AcheronProject/Jiu/resources/jiu_plate.dxf

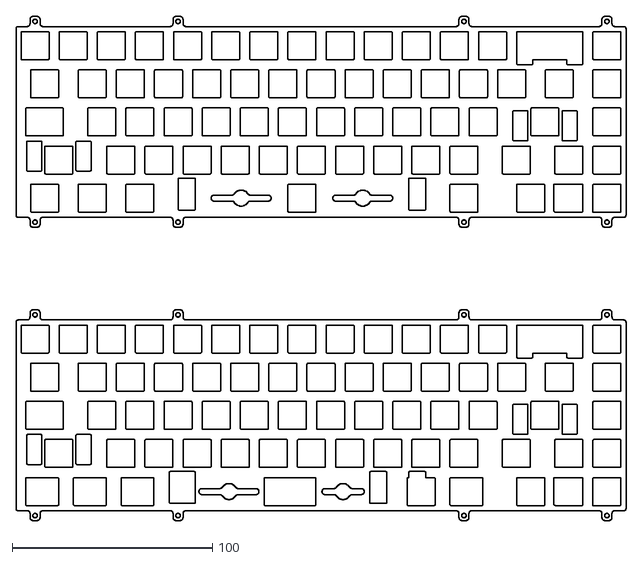
[picture p1: CAD file, 2021-01-12]
resources/jiu_plate.dxf
304.8 x 251.9
