AcheronProject/Jiu/resources/jiu.dxf

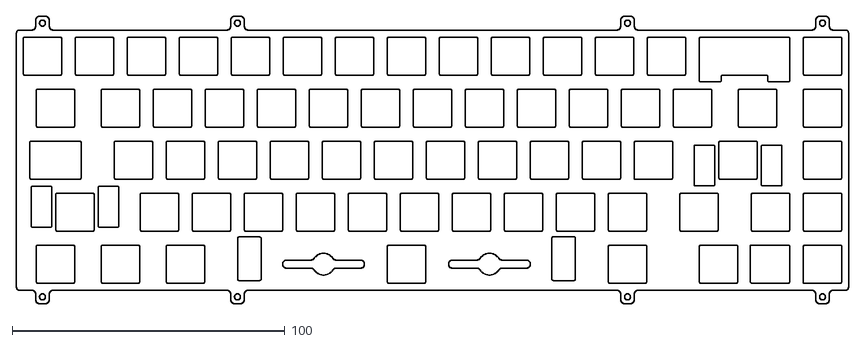
[picture p2: CAD file, 2021-01-12]
resources/jiu.dxf
304.8 x 105.3
