AcheronProject/Jiu/pcb_kicad_files/jiu.kicad_sch

## KiCad design pcb_kicad_files/jiu.kicad_sch (2021-12-22, an earlier design)

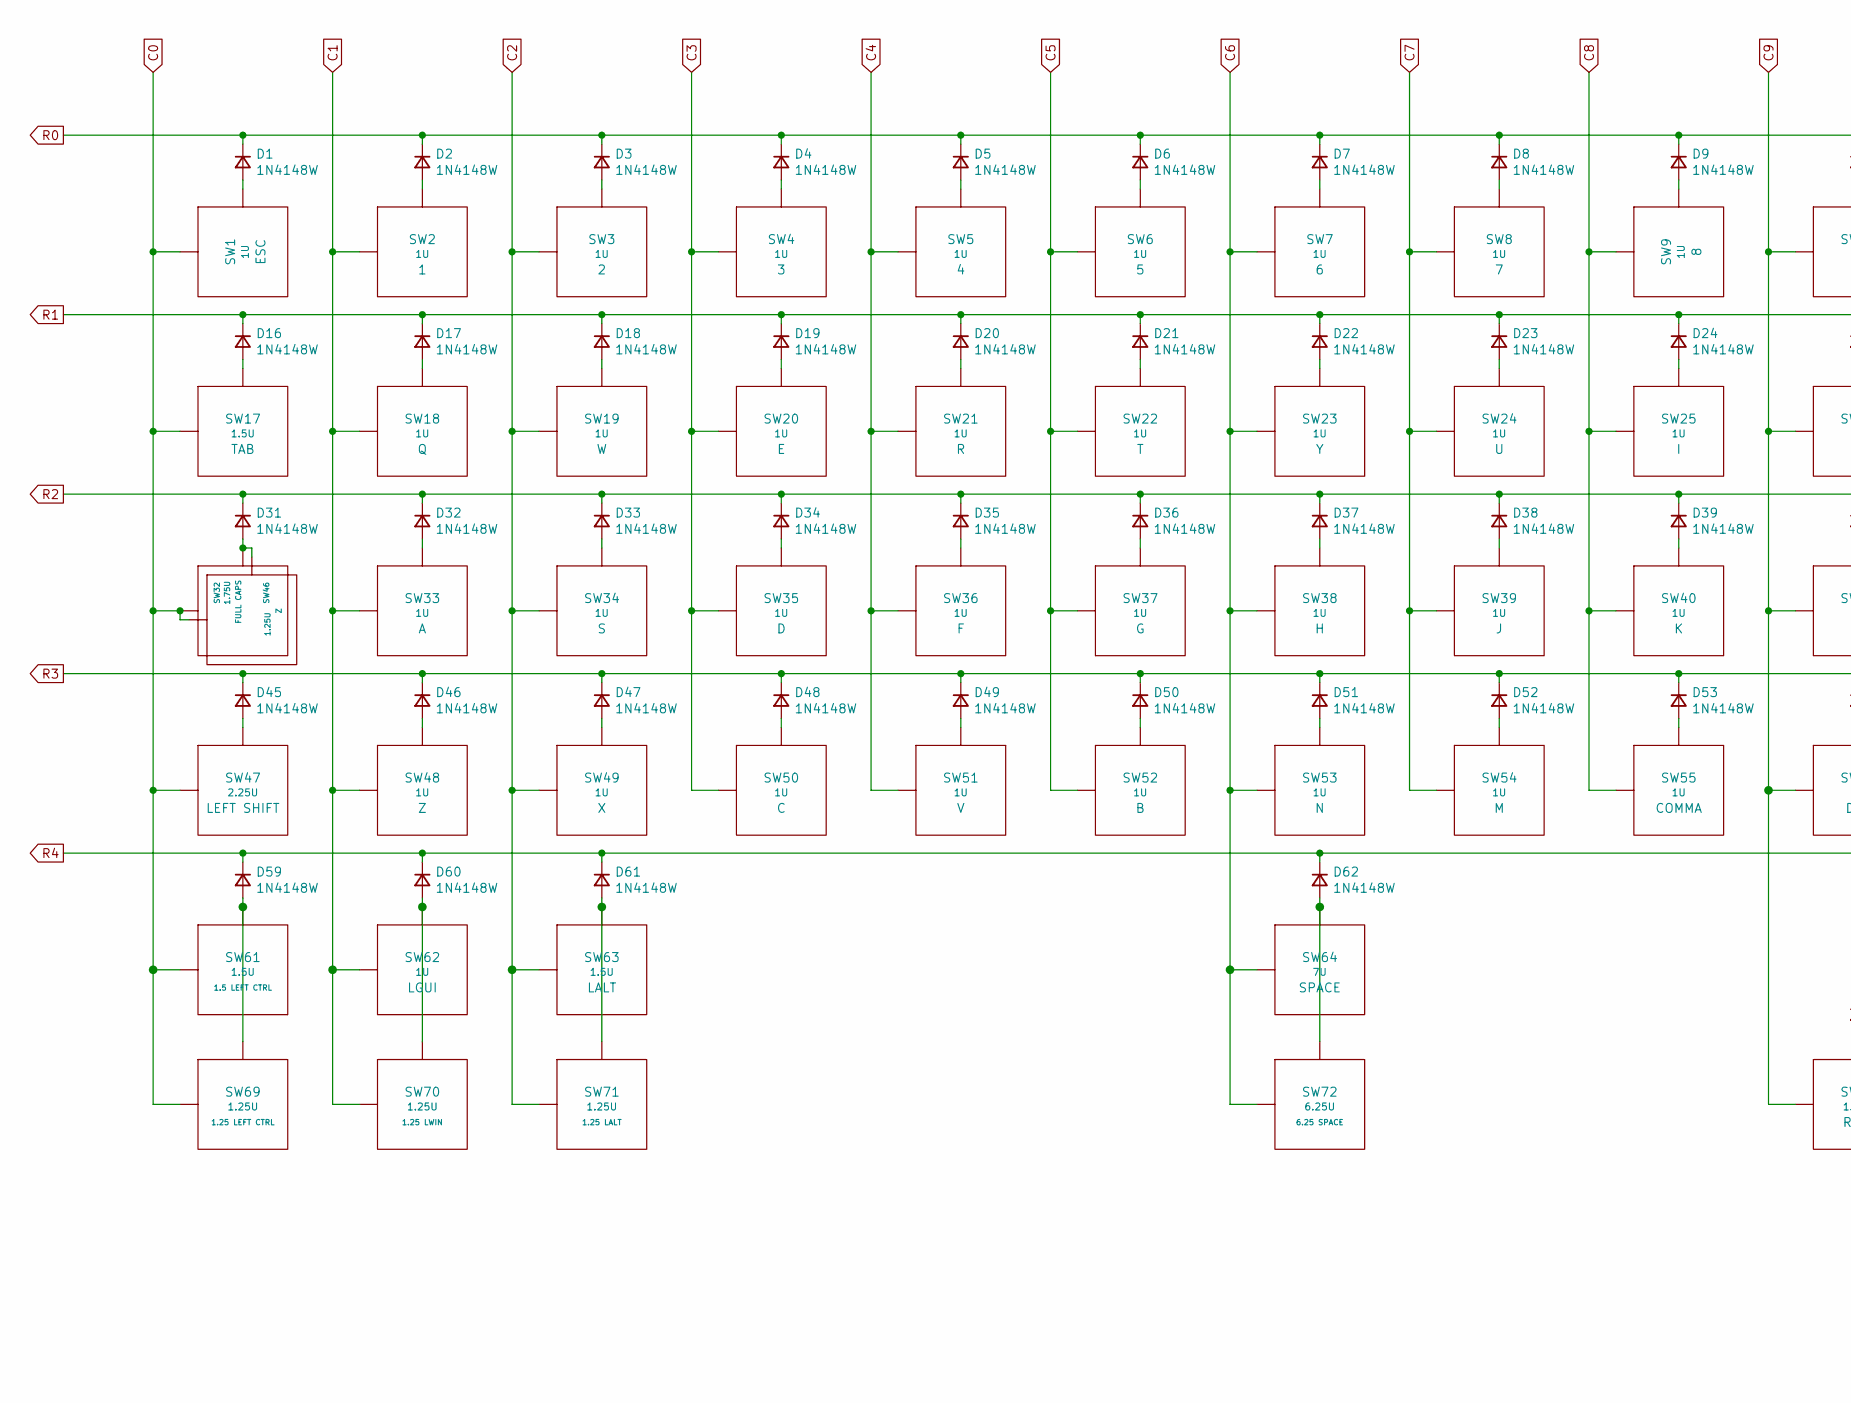
[picture p3: schematic jiu.kicad_sch, part in row 1, column 1]

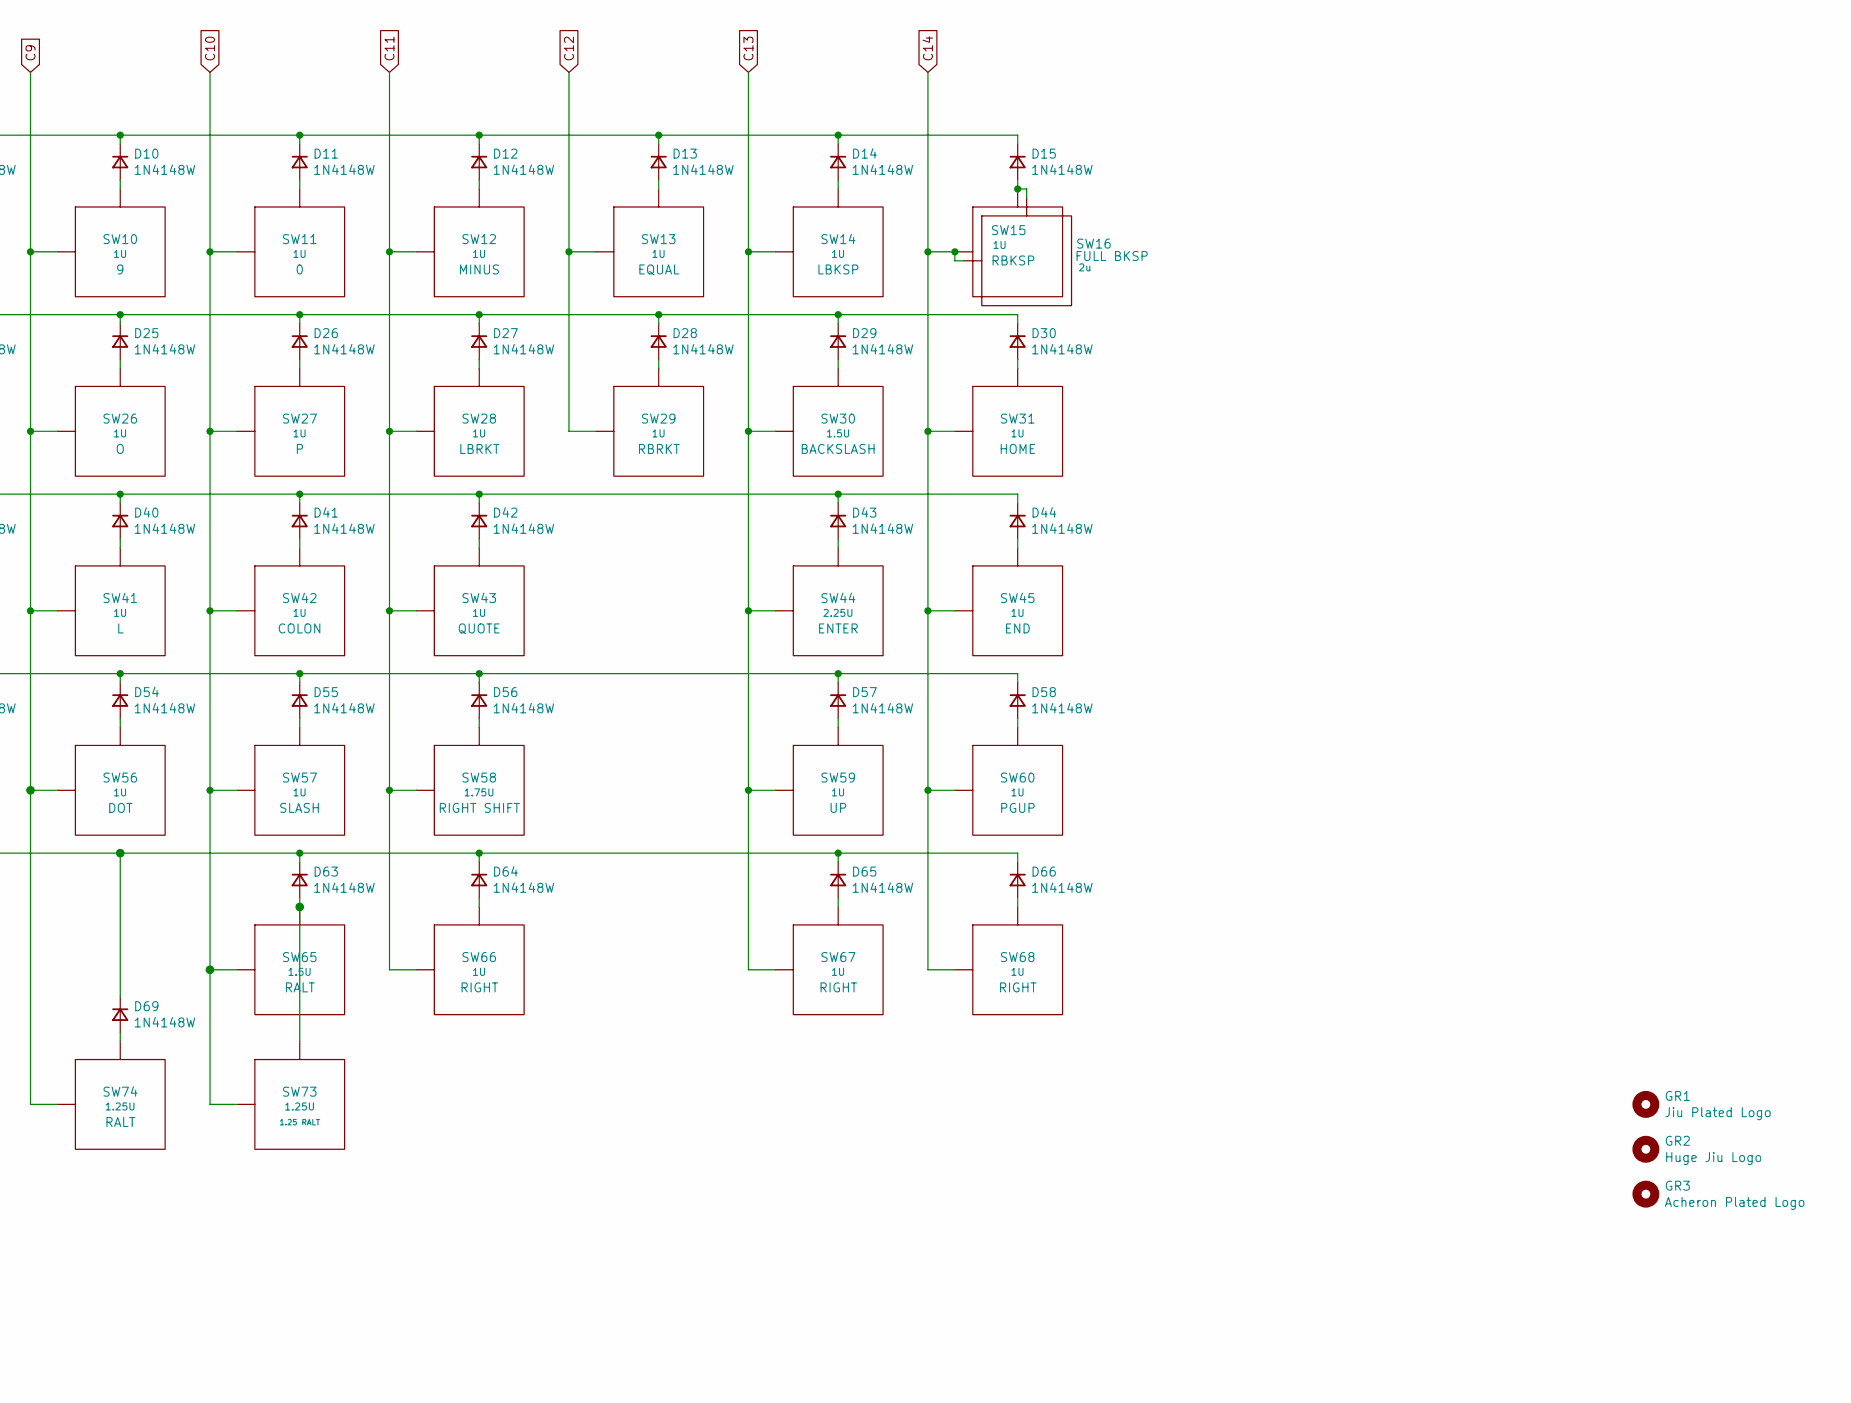
[picture p4: schematic jiu.kicad_sch, part in row 1, column 2]

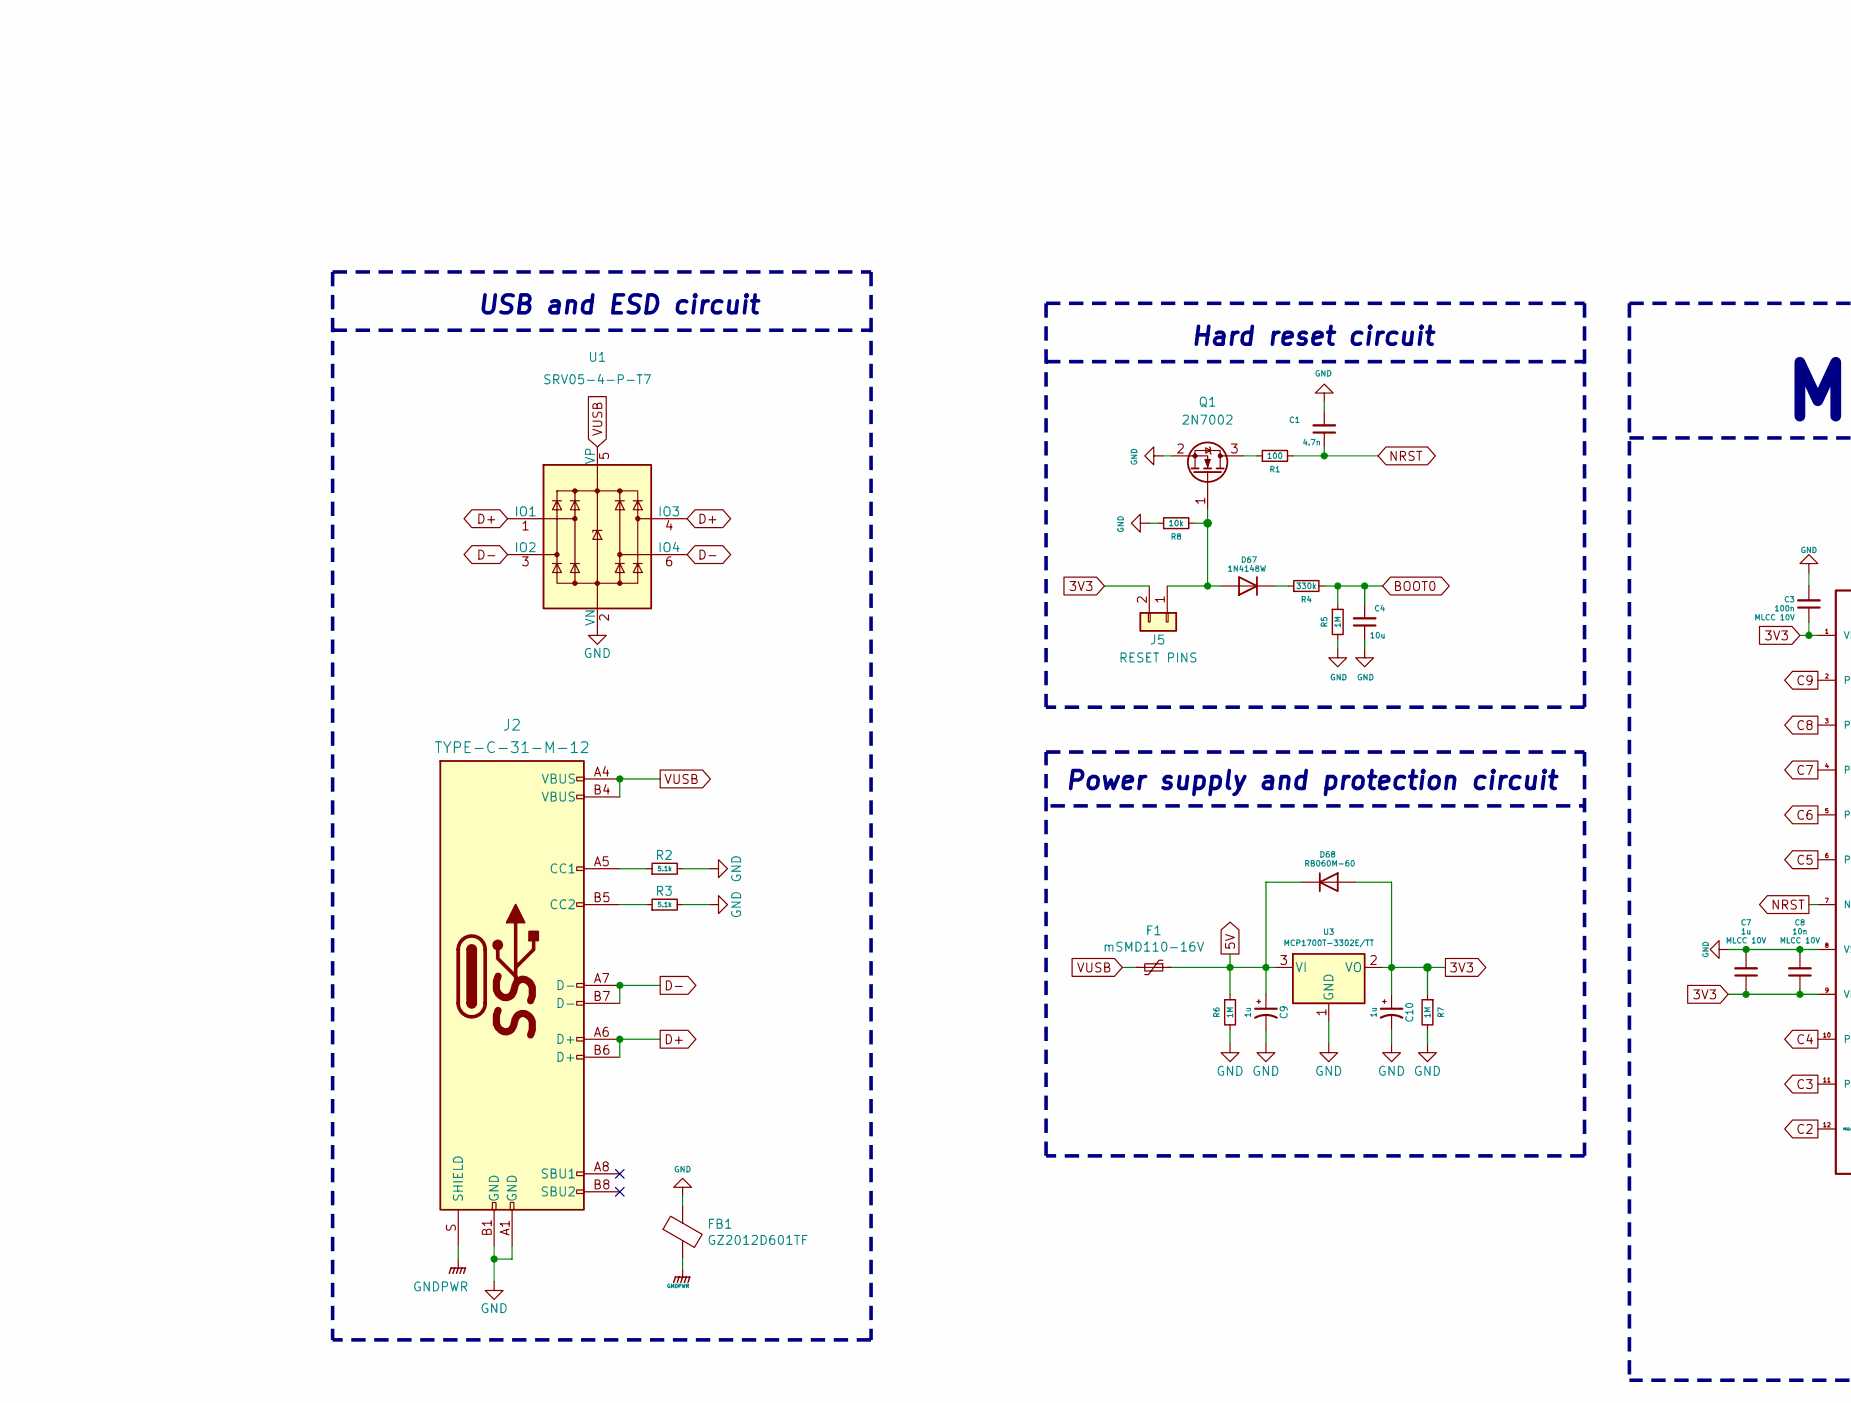
[picture p5: schematic jiu.kicad_sch, part in row 2, column 1]

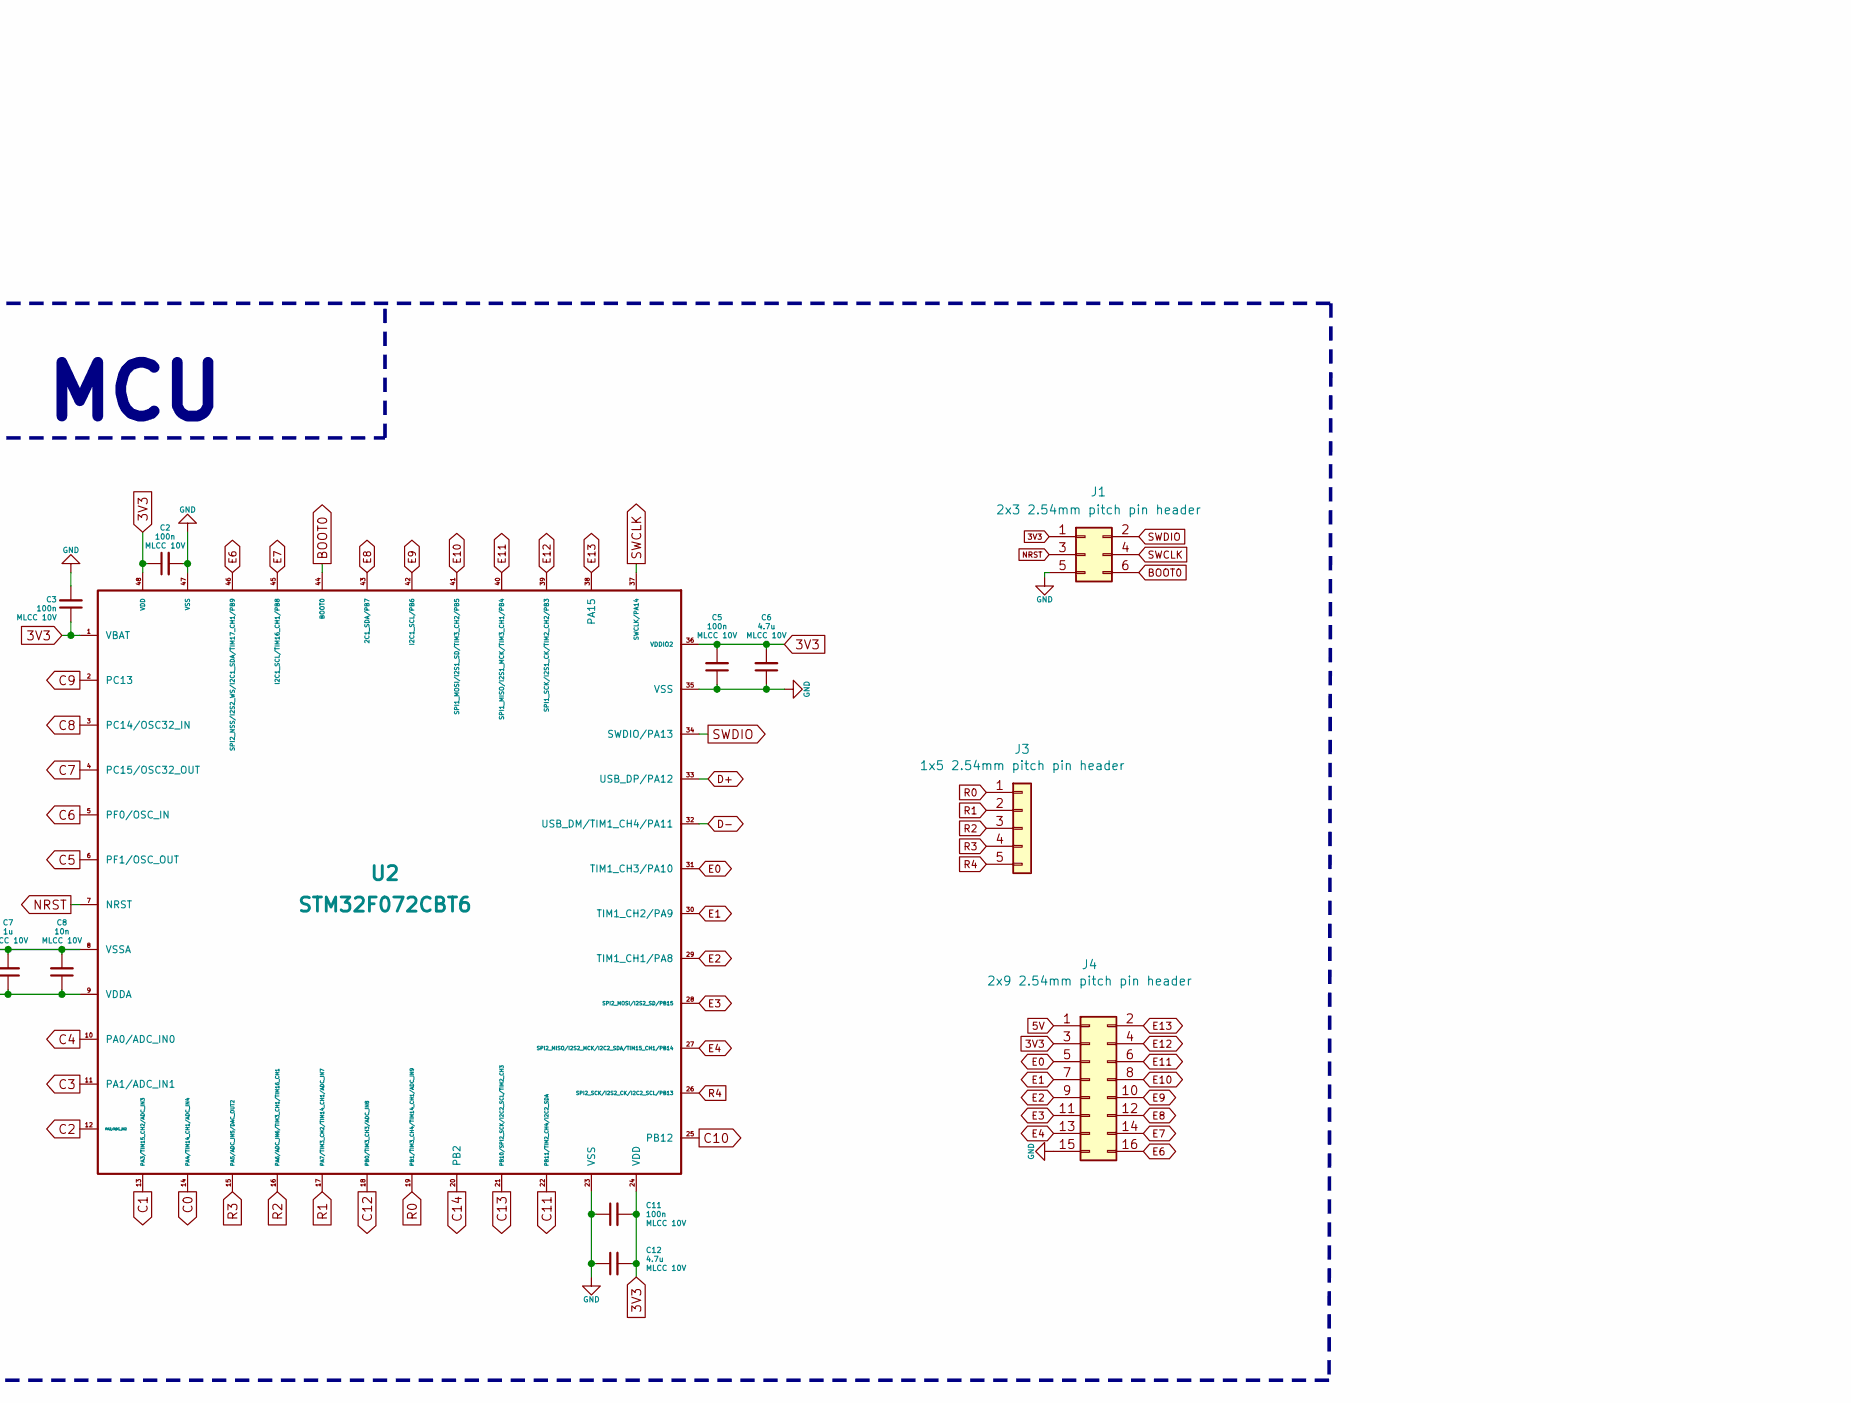
[picture p6: schematic jiu.kicad_sch, part in row 2, column 2]

Parts:
C1: 4.7n; C_0805_2012Metric
C2, C3, C5, C11: 100n; C_0402_1005Metric
C4: 10u; C_0805_2012Metric
C6, C12: 4.7u; C_0402_1005Metric
C7: 1u; C_0402_1005Metric
C8: 10n; C_0402_1005Metric
C9, C10: 1u; CP_EIA-3216-10_Kemet-I_Pad1.58x1.35mm_HandSolder
D1, D2, D3, D4, D5, D6, D7, D8, D9, D10, D11, D12, D13, D14, D15, D16, D17, D18, D19, D20, D21, D22, D23, D24, D25, D26, D27, D28, D29, D30, D31, D32, D33, D34, D35, D36, D37, D38, D39, D40, D41, D42, D43, D44, D45, D46, D47, D48, D49, D50, D51, D52, D53, D54, D55, D56, D57, D58, D59, D60, D61, D62, D63, D64, D65, D66, D67, D69: 1N4148W; D_SOD-123
D68: RB060M-60; D_SOD-123; Manufacturer Part Number RB060M-60; LCSC Part Number C115330
F1: mSMD110-16V; Fuse_1812_4532; Manufacturer Part Number mSMD110-16V; LCSC Part Number C69691
FB1: GZ2012D601TF; L_0805_2012Metric; Manufacturer Part Number CBW321609U121T; LCSC Part Number C1017
GR1: Jiu Plated Logo; jiu_logo_15.9x15.0mm
GR2: Huge Jiu Logo; jiu_logo_80x75.6
GR3: Acheron Plated Logo; acheronShort_0.3x0.5in_Plated
J1: 2x3 2.54mm pitch pin header; Conn_ARM_JTAG_SWD_6
J2: TYPE-C-31-M-12; Manufacturer Part Number TYPE-C-31-M-12; LCSC Part Number C165948
J3: 1x5 2.54mm pitch pin header; PinHeader_1x5_P2.54mm_Vertical
J4: 2x9 2.54mm pitch pin header; PinHeader_2x8_P2.54mm_Vertical
J5: RESET PINS; THT_reset_contacts
Q1: 2N7002; SOT-23; Manufacturer Part Number 2N7002; LCSC Part Number C8545
R1: 100; R_0805_2012Metric
R2, R3: 5.1k; R_0805_2012Metric
R4: 330k; R_0805_2012Metric
R5, R6, R7: 1M; R_0805_2012Metric
R8: 10k; R_0805_2012Metric
SW1, SW2, SW3, SW4, SW5, SW6, SW7, SW8, SW9, SW10, SW11, SW12, SW13, SW14, SW15, SW18, SW19, SW20, SW21, SW22, SW23, SW24, SW25, SW26, SW27, SW28, SW29, SW31, SW33, SW34, SW35, SW36, SW37, SW38, SW39, SW40, SW41, SW42, SW43, SW45, SW48, SW49, SW50, SW51, SW52, SW53, SW54, SW55, SW56, SW57, SW59, SW60, SW62, SW66, SW67, SW68: 1U; MX100
SW16: 2u; MX200
SW17, SW30, SW61, SW63, SW65: 1.5U; MX150
SW32, SW58: 1.75U; MX175
SW44: 2.25U; MX225
SW46, SW69, SW70, SW71, SW73, SW74: 1.25U; MX125
SW47: 2.25U; MX225R
SW64: 7U; MX700R
SW72: 6.25U; MX625R
U1: SRV05-4-P-T7; SOT-23-6; Manufacturer Part Number SRV05-4-P-T7; LCSC Part Number C85364
U2: STM32F072CBT6; LQFP-48_7x7mm_P0.5mm; Manufacturer Part Number STM32F072CBT6; LCSC Part Number C81720
U3: MCP1700T-3302E/TT; SOT-23; Manufacturer Part Number MCP1700T-3302E/TT; LCSC Part Number C39051

Connections:
3V3: C2.1, C3.1, C5.2, C6.2, C7.1, C8.1, C10.1, C11.2, C12.2, D68.2 (A), J1.1, J4.3, J5.2, R7.1, U2.1 (VBAT), U2.9 (VDDA), U2.24 (VDD), U2.36 (VDDIO2), U2.48 (VDD), U3.2 (VO)
5V: C9.1, D68.1 (K), F1.1, J4.1, R6.1, U3.3 (VI)
BOOT0: C4.2, J1.6, R4.2, R5.1, U2.44 (BOOT0)
C0: SW1.2 (Row), SW17.1 (Col), SW32.2 (Row), SW46.2 (Row), SW47.1 (Col), SW61.1 (Col), SW69.1 (Col), U2.14 (PA4/TIM14_CH1/ADC_IN4)
C1: SW2.1 (Col), SW18.1 (Col), SW33.1 (Col), SW48.1 (Col), SW62.1 (Col), SW70.1 (Col), U2.13 (PA3/TIM15_CH2/ADC_IN3)
C2: SW3.1 (Col), SW19.1 (Col), SW34.1 (Col), SW49.1 (Col), SW63.1 (Col), SW71.1 (Col), U2.12 (PA2/ADC_IN2)
C3: SW4.1 (Col), SW20.1 (Col), SW35.1 (Col), SW50.1 (Col), U2.11 (PA1/ADC_IN1)
C4: SW5.1 (Col), SW21.1 (Col), SW36.1 (Col), SW51.1 (Col), U2.10 (PA0/ADC_IN0)
C5: SW6.1 (Col), SW22.1 (Col), SW37.1 (Col), SW52.1 (Col), U2.6 (PF1/OSC_OUT)
C6: SW7.1 (Col), SW23.1 (Col), SW38.1 (Col), SW53.1 (Col), SW64.1 (Col), SW72.1 (Col), U2.5 (PF0/OSC_IN)
C7: SW8.1 (Col), SW24.1 (Col), SW39.1 (Col), SW54.1 (Col), U2.4 (PC15/OSC32_OUT)
C8: SW9.2 (Row), SW25.1 (Col), SW40.1 (Col), SW55.1 (Col), U2.3 (PC14/OSC32_IN)
C9: SW10.1 (Col), SW26.1 (Col), SW41.1 (Col), SW56.1 (Col), SW74.1 (Col), U2.2 (PC13)
C10: SW11.1 (Col), SW27.1 (Col), SW42.1 (Col), SW57.1 (Col), SW65.1 (Col), SW73.1 (Col), U2.25 (PB12)
C11: SW12.1 (Col), SW28.1 (Col), SW43.1 (Col), SW58.1 (Col), SW66.1 (Col), U2.22 (PB11/TIM2_CH4/I2C2_SDA)
C12: SW13.1 (Col), SW29.1 (Col), U2.18 (PB0/TIM3_CH3/ADC_IN8)
C13: SW14.1 (Col), SW30.1 (Col), SW44.1 (Col), SW59.1 (Col), SW67.1 (Col), U2.21 (PB10/SPI2_SCK/I2C2_SCL/TIM2_CH3)
C14: SW15.1 (Col), SW16.1 (Col), SW31.1 (Col), SW45.1 (Col), SW60.1 (Col), SW68.1 (Col), U2.20 (PB2)
D+: J2.A6 (D+), J2.B6 (D+), U1.1 (IO1), U1.4 (IO3), U2.33 (USB_DP/PA12)
D-: J2.A7 (D-), J2.B7 (D-), U1.3 (IO2), U1.6 (IO4), U2.32 (USB_DM/TIM1_CH4/PA11)
E0: J4.5, U2.31 (TIM1_CH3/PA10)
E1: J4.7, U2.30 (TIM1_CH2/PA9)
E2: J4.9, U2.29 (TIM1_CH1/PA8)
E3: J4.11, U2.28 (SPI2_MOSI/I2S2_SD/PB15)
E4: J4.13, U2.27 (SPI2_MISO/I2S2_MCK/I2C2_SDA/TIM15_CH1/P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)
E6: J4.16, U2.46 (SPI2_NSS/I2S2_WS/I2C1_SDA/TIM17_CH1/PB9)
E7: J4.14, U2.45 (I2C1_SCL/TIM16_CH1/PB8)
E8: J4.12, U2.43 (2C1_SDA/PB7)
E9: J4.10, U2.42 (I2C1_SCL/PB6)
E10: J4.8, U2.41 (SPI1_MOSI/I2S1_SD/TIM3_CH2/PB5)
E11: J4.6, U2.40 (SPI1_MISO/I2S1_MCK/TIM3_CH1/PB4)
E12: J4.4, U2.39 (SPI1_SCK/I2S1_CK/TIM2_CH2/PB3)
E13: J4.2, U2.38 (PA15)
GND: C1.2, C2.2, C3.2, C4.1, C5.1, C6.1, C7.2, C8.2, C9.2, C10.2, C11.1, C12.1, FB1.1, J1.5, J2.A1 (GND), J2.B1 (GND), J4.15, Q1.2 (S), R2.2, R3.2, R5.2, R6.2, R7.2, R8.1, U1.2 (VN), U2.8 (VSSA), U2.23 (VSS), U2.35 (VSS), U2.47 (VSS), U3.1 (GND)
GNDPWR: FB1.2, J2.S (SHIELD)
NRST: C1.1, J1.3, R1.2, U2.7 (NRST)
unnamed: D1.2 (A), SW1.1 (Col)
unnamed: D2.2 (A), SW2.2 (Row)
unnamed: D3.2 (A), SW3.2 (Row)
unnamed: D4.2 (A), SW4.2 (Row)
unnamed: D5.2 (A), SW5.2 (Row)
unnamed: D6.2 (A), SW6.2 (Row)
unnamed: D7.2 (A), SW7.2 (Row)
unnamed: D8.2 (A), SW8.2 (Row)
unnamed: D9.2 (A), SW9.1 (Col)
unnamed: D10.2 (A), SW10.2 (Row)
unnamed: D11.2 (A), SW11.2 (Row)
unnamed: D12.2 (A), SW12.2 (Row)
unnamed: D13.2 (A), SW13.2 (Row)
unnamed: D14.2 (A), SW14.2 (Row)
unnamed: D15.2 (A), SW15.2 (Row), SW16.2 (Row)
unnamed: D16.2 (A), SW17.2 (Row)
unnamed: D17.2 (A), SW18.2 (Row)
unnamed: D18.2 (A), SW19.2 (Row)
unnamed: D19.2 (A), SW20.2 (Row)
unnamed: D20.2 (A), SW21.2 (Row)
unnamed: D21.2 (A), SW22.2 (Row)
unnamed: D22.2 (A), SW23.2 (Row)
unnamed: D23.2 (A), SW24.2 (Row)
unnamed: D24.2 (A), SW25.2 (Row)
unnamed: D25.2 (A), SW26.2 (Row)
unnamed: D26.2 (A), SW27.2 (Row)
unnamed: D27.2 (A), SW28.2 (Row)
unnamed: D28.2 (A), SW29.2 (Row)
unnamed: D29.2 (A), SW30.2 (Row)
unnamed: D30.2 (A), SW31.2 (Row)
unnamed: D31.2 (A), SW32.1 (Col), SW46.1 (Col)
unnamed: D32.2 (A), SW33.2 (Row)
unnamed: D33.2 (A), SW34.2 (Row)
unnamed: D34.2 (A), SW35.2 (Row)
unnamed: D35.2 (A), SW36.2 (Row)
unnamed: D36.2 (A), SW37.2 (Row)
unnamed: D37.2 (A), SW38.2 (Row)
unnamed: D38.2 (A), SW39.2 (Row)
unnamed: D39.2 (A), SW40.2 (Row)
unnamed: D40.2 (A), SW41.2 (Row)
unnamed: D41.2 (A), SW42.2 (Row)
unnamed: D42.2 (A), SW43.2 (Row)
unnamed: D43.2 (A), SW44.2 (Row)
unnamed: D44.2 (A), SW45.2 (Row)
unnamed: D45.2 (A), SW47.2 (Row)
unnamed: D46.2 (A), SW48.2 (Row)
unnamed: D47.2 (A), SW49.2 (Row)
unnamed: D48.2 (A), SW50.2 (Row)
unnamed: D49.2 (A), SW51.2 (Row)
unnamed: D50.2 (A), SW52.2 (Row)
unnamed: D51.2 (A), SW53.2 (Row)
unnamed: D52.2 (A), SW54.2 (Row)
unnamed: D53.2 (A), SW55.2 (Row)
unnamed: D54.2 (A), SW56.2 (Row)
unnamed: D55.2 (A), SW57.2 (Row)
unnamed: D56.2 (A), SW58.2 (Row)
unnamed: D57.2 (A), SW59.2 (Row)
unnamed: D58.2 (A), SW60.2 (Row)
unnamed: D59.2 (A), SW61.2 (Row), SW69.2 (Row)
unnamed: D60.2 (A), SW62.2 (Row), SW70.2 (Row)
unnamed: D61.2 (A), SW63.2 (Row), SW71.2 (Row)
unnamed: D62.2 (A), SW64.2 (Row), SW72.2 (Row)
unnamed: D63.2 (A), SW65.2 (Row), SW73.2 (Row)
unnamed: D64.2 (A), SW66.2 (Row)
unnamed: D65.2 (A), SW67.2 (Row)
unnamed: D66.2 (A), SW68.2 (Row)
unnamed: D67.1 (K), R4.1
unnamed: D67.2 (A), J5.1, Q1.1 (G), R8.2
unnamed: D69.2 (A), SW74.2 (Row)
unnamed: J2.A5 (CC1), R2.1
unnamed: J2.B5 (CC2), R3.1
unnamed: Q1.3 (D), R1.1
R0: D1.1 (K), D2.1 (K), D3.1 (K), D4.1 (K), D5.1 (K), D6.1 (K), D7.1 (K), D8.1 (K), D9.1 (K), D10.1 (K), D11.1 (K), D12.1 (K), D13.1 (K), D14.1 (K), D15.1 (K), J3.1, U2.19 (PB1/TIM3_CH4/TIM14_CH1/ADC_IN9)
R1: D16.1 (K), D17.1 (K), D18.1 (K), D19.1 (K), D20.1 (K), D21.1 (K), D22.1 (K), D23.1 (K), D24.1 (K), D25.1 (K), D26.1 (K), D27.1 (K), D28.1 (K), D29.1 (K), D30.1 (K), J3.2, U2.17 (PA7/TIM3_CH2/TIM14_CH1/ADC_IN7)
R2: D31.1 (K), D32.1 (K), D33.1 (K), D34.1 (K), D35.1 (K), D36.1 (K), D37.1 (K), D38.1 (K), D39.1 (K), D40.1 (K), D41.1 (K), D42.1 (K), D43.1 (K), D44.1 (K), J3.3, U2.16 (PA6/ADC_IN6/TIM3_CH1/TIM16_CH1)
R3: D45.1 (K), D46.1 (K), D47.1 (K), D48.1 (K), D49.1 (K), D50.1 (K), D51.1 (K), D52.1 (K), D53.1 (K), D54.1 (K), D55.1 (K), D56.1 (K), D57.1 (K), D58.1 (K), J3.4, U2.15 (PA5/ADC_IN5/DAC_OUT2)
R4: D59.1 (K), D60.1 (K), D61.1 (K), D62.1 (K), D63.1 (K), D64.1 (K), D65.1 (K), D66.1 (K), D69.1 (K), J3.5, U2.26 (SPI2_SCK/I2S2_CK/I2C2_SCL/PB13)
SWCLK: J1.4, U2.37 (SWCLK/PA14)
SWDIO: J1.2, U2.34 (SWDIO/PA13)
VUSB: F1.2, J2.A4 (VBUS), J2.B4 (VBUS), U1.5 (VP)

Notes on the sheet:
Power supply and protection circuit
USB and ESD circuit
MCU
Hard reset circuit
