AcheronProject/Jiu/(commit log)

2021-01-12 First version, first commit
    [jiu.dxf, jiu.kicad_sch, jiu_plate.dxf]
2021-01-12 Added plate files
    [jiu_plate.kicad_pcb, jiu_plate.kicad_sch]
2021-01-13 Added pin header esposing extra unused MCU pins
    [jiu.kicad_sch]
2021-01-13 Add pin header for rows
    [jiu.kicad_sch]
2021-01-13 Added USBLC chip, removed discrete TVS, organized LDO circuitry
    [jiu.kicad_sch]
2021-01-14 Add Acheron Plated logo to PCB front
    [jiu.kicad_sch]
2021-01-14 Added metadata to some components
    [jiu.kicad_sch]
2021-01-14 Added ferrite bead to USB shield and ground
    [jiu.kicad_sch]
2021-01-14 Preparing for pre-release Alpha
    [jiu.kicad_sch, jiu_plate.kicad_pcb]
2021-01-14 Add PCB renders to README
2021-02-03 Change components and ratings to JLC assembly
    - Components were swapped for units that could be soldered in JLCPCB's assembly using the most basic components possible
    - All resistors were changed to 0805
    - Reset button was removed and instead reset contacts were exposed; resetting PCB will require shorting the contacts with pliers
    - Reset circuitry was changed for a 2N7002 MOSFET variant since JLC has no digital transistors in their roster of basic parts
    - USB connector and MCU could not be changed as there are no equivalent substitutes in the basic parts but they are completely essential
    - USB ESD device was changed for a four-way variant that is a JLC basic part; USB data traces were chang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
    [jiu.kicad_sch]
2021-02-21 New KiCad version, update PCB page version to 1.1.7
    [jiu.csv]
2021-02-21 Remove pin header connectors from BoM
    [jiu.csv, jiu.kicad_sch]
2021-02-21 Pin row 4 to B13, change extra pin header to 2x8 from 2x9
    [jiu.kicad_sch]
2021-03-07 Added prototype pictures to README
2021-03-08 Fix missing 6.25U bottom row key
    [jiu.kicad_sch]
2021-12-22 gitignore, stab orientation
    - Added backup files to gitignore
    - Fix enter, right shift keys stab orientations
    - New KiCAD version
    [jiu.dxf, jiu.kicad_sch, jiu_plate.dxf, jiu_plate.kicad_pcb, jiu_plate.kicad_sch]
2021-12-22 Most MCU routing
    [jiu.kicad_sch]
